ytsurui/RP2040CommandStation/README.md

# RP2040-Based DCC Command Station

underconstruction
