ytsurui/RP2040CommandStation/Board-LargePower/KiCad6/3dmodel/HSIP7_TOS.step

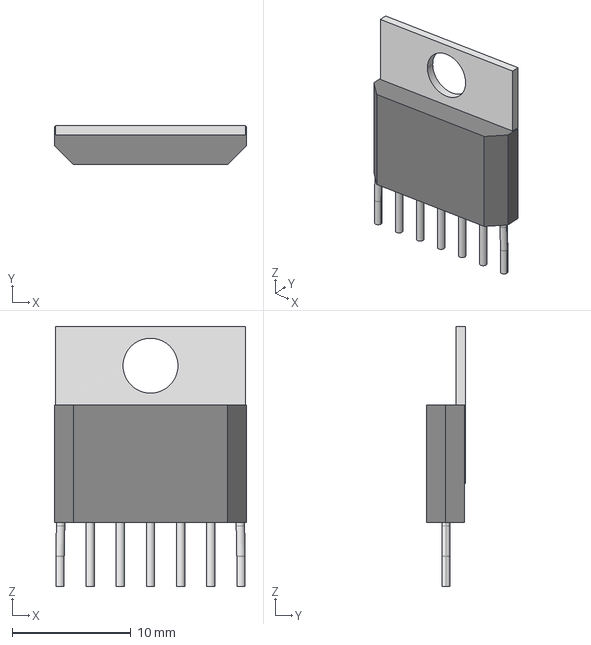
[picture p1: CAD file, 2023-01-30]
Board-LargePower/KiCad6/3dmodel/HSIP7_TOS.step
16.2 x 3.30 x 21.9 mm
