ytsurui/RP2040CommandStation/Board-LargePower/KiCad6/3dmodel/CUI_PJ-002A.igs

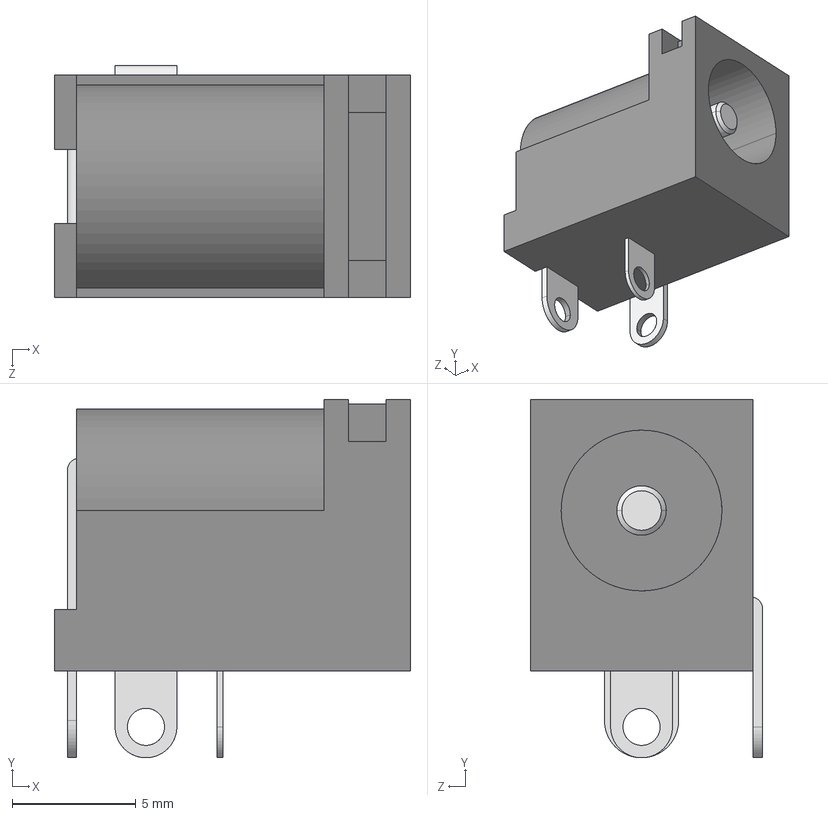
[picture p2: CAD file, 2023-01-30]
Board-LargePower/KiCad6/3dmodel/CUI_PJ-002A.igs
14.4 x 14.5 x 9.40 mm
