ytsurui/RP2040CommandStation/Board-LargePower/KiCad6/3dmodel/KUSBEX-BSFS1N-W_A.STEP

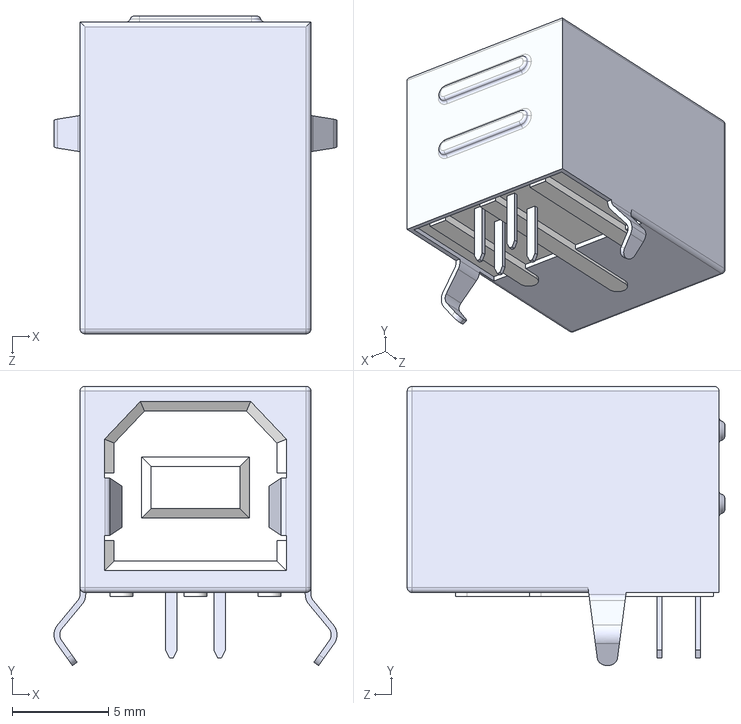
[picture p3: CAD file, 2023-01-30]
Board-LargePower/KiCad6/3dmodel/KUSBEX-BSFS1N-W_A.STEP
14.7 x 14.5 x 16.5 mm
