ytsurui/RP2040CommandStation/Board-UltraPower/KiCad6/RP2040CommandStation.kicad_pcb

## KiCad design Board-UltraPower/KiCad6/RP2040CommandStation.kicad_pcb (2023-06-03)

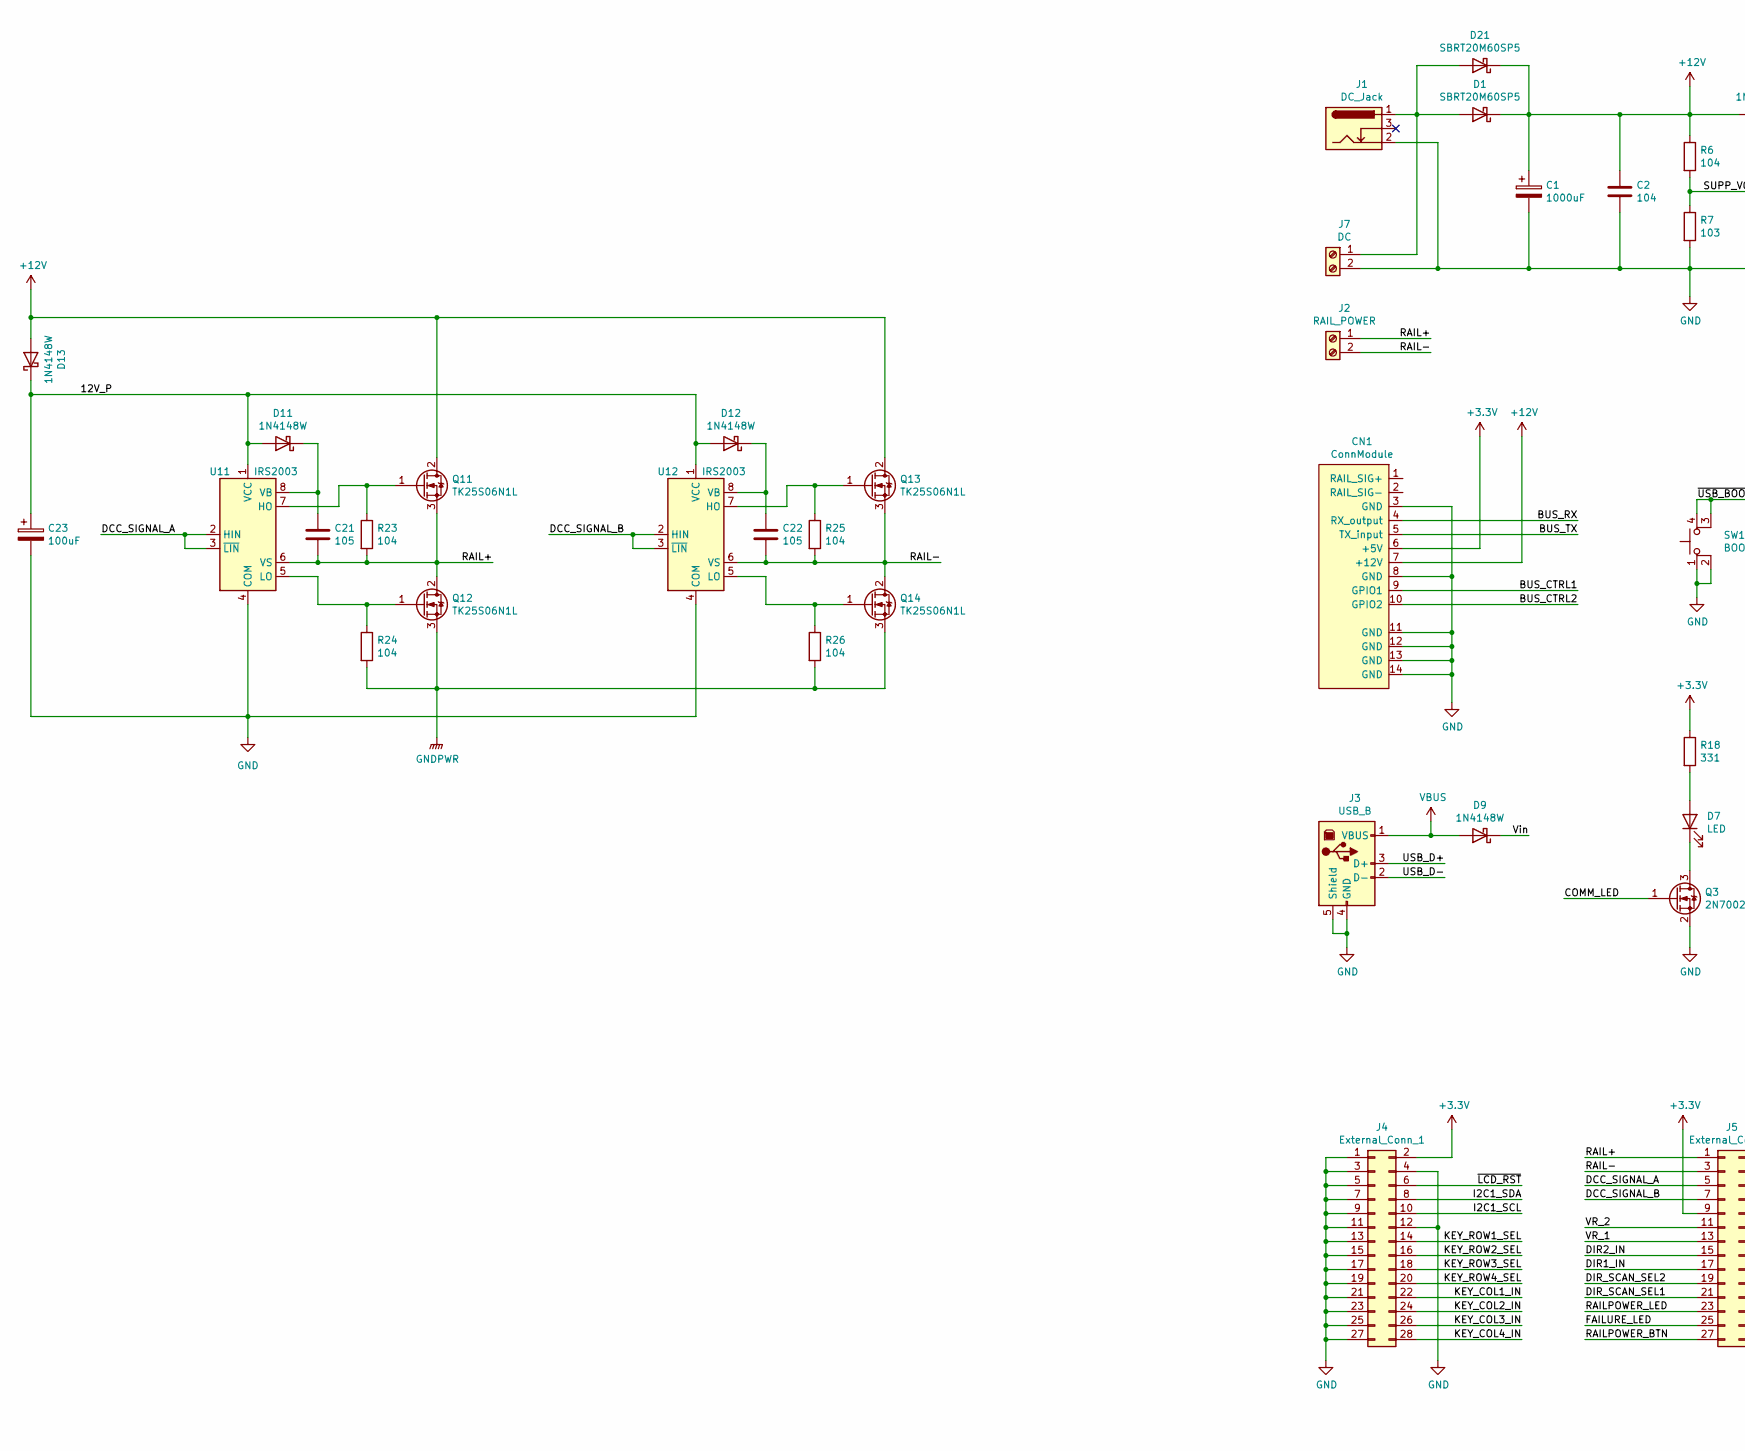
[picture p4: schematic RP2040CommandStation.kicad_sch, part in row 1, column 1]

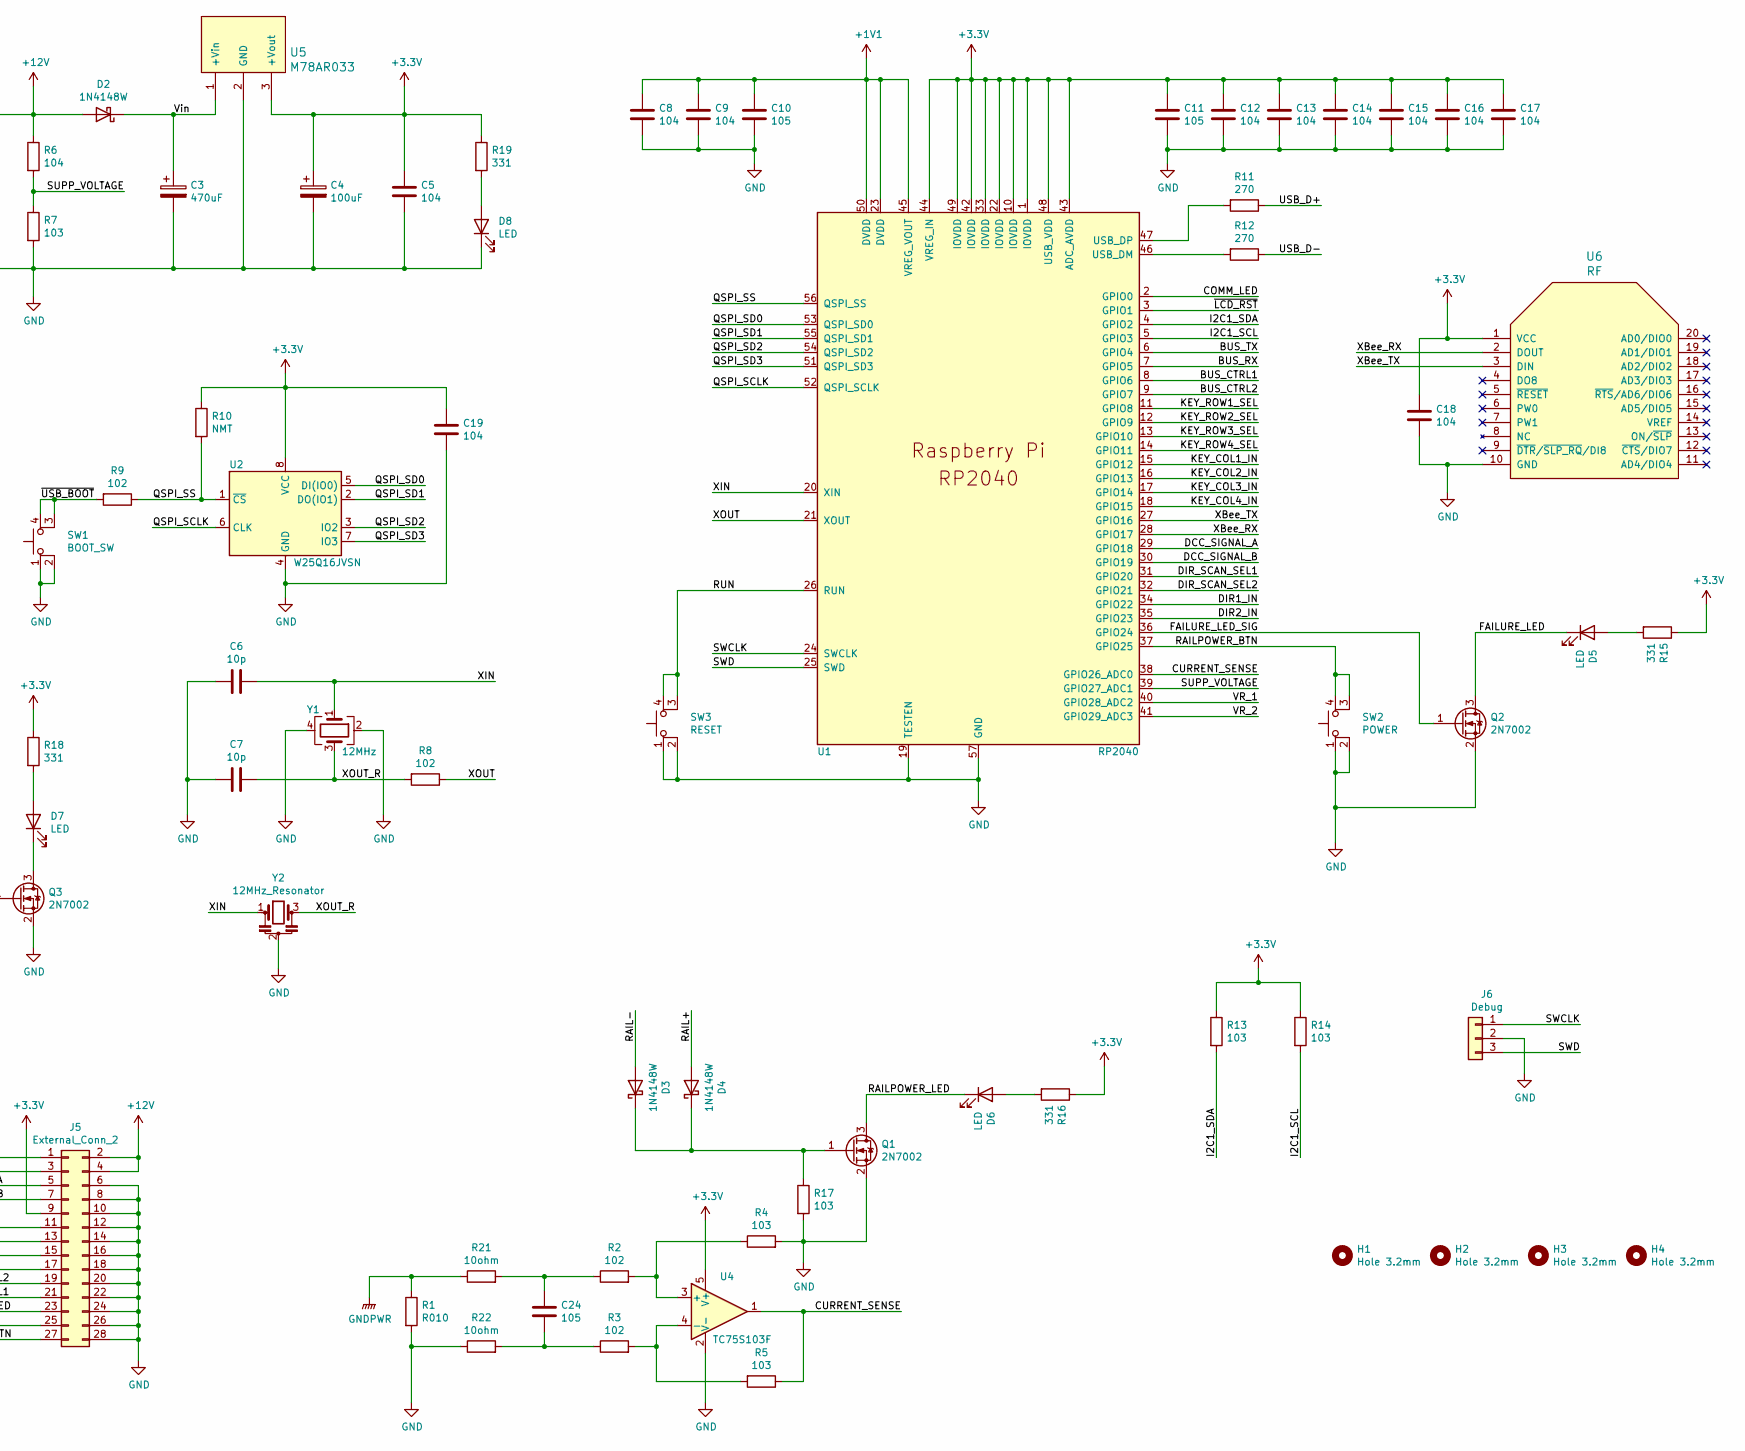
[picture p5: schematic RP2040CommandStation.kicad_sch, part in row 1, column 2]

Parts:
C1: 1000uF; CAP_TH_12_5
C2, C5, C8, C9, C12, C13, C14, C15, C16, C17, C18, C19: 104; C_1005
C3: 470uF; CAP_TH_8x11_5
C4, C23: 100uF; CAP_TH_5x11
C6, C7: 10p; C_1005
C10, C11, C21, C22, C24: 105; C_1005
CN1: ConnModule; CommModuleTiny
D1, D21: SBRT20M60SP5; POWERDI5
D2, D3, D4, D9, D11, D12, D13: 1N4148W; SOD-123FL
D5, D6, D7, D8: LED; LED_3mm
H1, H2, H3, H4: Hole 3.2mm; HOLE_3.2mm
J1: DC_Jack; BARREL_JACK
J2: RAIL_POWER; TB111-2
J3: USB_B
J4: External_Conn_1; PinSocket_2x14_2_54mm
J5: External_Conn_2; PinSocket_2x14_2_54mm
J6: Debug; PinHeader_01x03
J7: DC; TB111-2
Q1, Q2, Q3: 2N7002; SOT-23
Q11, Q12, Q13, Q14: TK25S06N1L; DPAK+
R1: R010; R_6432
R2, R3, R8, R9: 102; R_1608
R4, R5, R7, R13, R14, R17: 103; R_1608
R6, R23, R24, R25, R26: 104; R_1608
R10: NMT; R_1608
R11, R12: 270; R_1608
R15, R16, R18, R19: 331; R_1608
R21, R22: 10ohm; R_1608
SW1: BOOT_SW; TS-0606
SW2: POWER; TS-0606
SW3: RESET; TS-0606
U1: RP2040; RP2040-QFN-56
U2: W25Q16JVSN; SO-8
U4: TC75S103F; SOT-23-5
U5: M78AR033; M78AR0XX
U6: RF; XBee
U11, U12: IRS2003; SO-8
Y1: 12MHz; FA-238_Crystal
Y2: 12MHz_Resonator; SMD_Resonator_3213

Connections:
+1V1: C8.1, C9.1, C10.1, U1.23 (DVDD), U1.45 (VREG_VOUT), U1.50 (DVDD)
+3.3V: C4.1, C5.1, C11.1, C12.1, C13.1, C14.1, C15.1, C16.1, C17.1, C18.1, C19.1, CN1.6 (+5V), J4.2, J5.9, R10.1, R13.1, R14.1, R15.1, R16.1, R18.1, R19.1, U1.1 (IOVDD), U1.10 (IOVDD), U1.22 (IOVDD), U1.33 (IOVDD), U1.42 (IOVDD), U1.43 (ADC_AVDD), U1.44 (VREG_IN), U1.48 (USB_VDD), U1.49 (IOVDD), U2.8 (VCC), U4.5 (V+), U5.3 (+Vout), U6.1 (VCC)
+12V: C1.1, C2.1, CN1.7 (+12V), D1.1 (K), D2.2 (A), D13.2 (A), D21.1 (K), J5.2, J5.4, Q11.2 (D), Q13.2 (D), R6.1
/12V_P: C23.1, D11.2 (A), D12.2 (A), D13.1 (K), U11.1 (VCC), U12.1 (VCC)
/BUS_CTRL1: CN1.9 (GPIO1), U1.8 (GPIO6)
/BUS_CTRL2: CN1.10 (GPIO2), U1.9 (GPIO7)
/BUS_RX: CN1.4 (RX_output), U1.7 (GPIO5)
/BUS_TX: CN1.5 (TX_input), U1.6 (GPIO4)
/COMM_LED: Q3.1 (G), U1.2 (GPIO0)
/CURRENT_SENSE: R5.1, U1.38 (GPIO26_ADC0), U4.1
/DCC_SIGNAL_A: J5.5, U1.29 (GPIO18), U11.2 (HIN), U11.3 (~LIN)
/DCC_SIGNAL_B: J5.7, U1.30 (GPIO19), U12.2 (HIN), U12.3 (~LIN)
/DIR1_IN: J5.17, U1.34 (GPIO22)
/DIR2_IN: J5.15, U1.35 (GPIO23)
/DIR_SCAN_SEL1: J5.21, U1.31 (GPIO20)
/DIR_SCAN_SEL2: J5.19, U1.32 (GPIO21)
/FAILURE_LED: D5.1 (K), J5.25, Q2.3 (D)
/FAILURE_LED_SIG: Q2.1 (G), U1.36 (GPIO24)
/I2C1_SCL: J4.10, R14.2, U1.5 (GPIO3)
/I2C1_SDA: J4.8, R13.2, U1.4 (GPIO2)
/KEY_COL1_IN: J4.22, U1.15 (GPIO12)
/KEY_COL2_IN: J4.24, U1.16 (GPIO13)
/KEY_COL3_IN: J4.26, U1.17 (GPIO14)
/KEY_COL4_IN: J4.28, U1.18 (GPIO15)
/KEY_ROW1_SEL: J4.14, U1.11 (GPIO8)
/KEY_ROW2_SEL: J4.16, U1.12 (GPIO9)
/KEY_ROW3_SEL: J4.18, U1.13 (GPIO10)
/KEY_ROW4_SEL: J4.20, U1.14 (GPIO11)
/QSPI_SCLK: U1.52 (QSPI_SCLK), U2.6 (CLK)
/QSPI_SD0: U1.53 (QSPI_SD0), U2.5 (DI(IO0))
/QSPI_SD1: U1.55 (QSPI_SD1), U2.2 (DO(IO1))
/QSPI_SD2: U1.54 (QSPI_SD2), U2.3 (IO2)
/QSPI_SD3: U1.51 (QSPI_SD3), U2.7 (IO3)
/QSPI_SS: R9.1, R10.2, U1.56 (QSPI_SS), U2.1 (~CS)
/RAIL+: C21.2, D4.2 (A), J2.1, J5.1, Q11.3 (S), Q12.2 (D), R23.2, U11.6 (VS)
/RAIL-: C22.2, D3.2 (A), J2.2, J5.3, Q13.3 (S), Q14.2 (D), R25.2, U12.6 (VS)
/RAILPOWER_BTN: J5.27, SW2.3 (K), SW2.4 (A), U1.37 (GPIO25)
/RAILPOWER_LED: D6.1 (K), J5.23, Q1.3 (D)
/RUN: SW3.3 (K), SW3.4 (A), U1.26 (RUN)
/SUPP_VOLTAGE: R6.2, R7.1, U1.39 (GPIO27_ADC1)
/SWCLK: J6.1, U1.24 (SWCLK)
/SWD: J6.3, U1.25 (SWD)
/USB_D+: J3.3 (D+), R11.1
/USB_D-: J3.2 (D-), R12.1
/VR_1: J5.13, U1.40 (GPIO28_ADC2)
/VR_2: J5.11, U1.41 (GPIO29_ADC3)
/Vin: C3.1, D2.1 (K), D9.1 (K), U5.1 (+Vin)
/XBee_RX: U1.28 (GPIO17), U6.2 (DOUT)
/XBee_TX: U1.27 (GPIO16), U6.3 (DIN)
/XIN: C6.1, U1.20 (XIN), Y1.1, Y2.1
/XOUT: R8.1, U1.21 (XOUT)
/XOUT_R: C7.1, R8.2, Y1.3, Y2.3
/~LCD_RST: J4.6, U1.3 (GPIO1)
/~USB_BOOT: R9.2, SW1.3 (K), SW1.4 (A)
GNDPWR: Q12.3 (S), Q14.3 (S), R1.1, R21.1, R24.2, R26.2
unnamed: C21.1, D11.1 (K), U11.8 (VB)
unnamed: C22.1, D12.1 (K), U12.8 (VB)
unnamed: C24.1, R2.1, R21.2
unnamed: C24.2, R3.1, R22.2
unnamed: D1.2 (A), D21.2 (A), J1.1, J7.1
unnamed: D3.1 (K), D4.1 (K), Q1.1 (G), R17.1
unnamed: D5.2 (A), R15.2
unnamed: D6.2 (A), R16.2
unnamed: D7.1 (K), Q3.3 (D)
unnamed: D7.2 (A), R18.2
unnamed: D8.2 (A), R19.2
unnamed: Q11.1 (G), R23.1, U11.7 (HO)
unnamed: Q13.1 (G), R25.1, U12.7 (HO)
unnamed: Q14.1 (G), R26.1, U12.5 (LO)
unnamed: R2.2, R4.1, U4.3 (+)
unnamed: R3.2, R5.2, U4.4 (-)
unnamed: R11.2, U1.47 (USB_DP)
unnamed: R12.2, U1.46 (USB_DM)
unnamed: Q12.1 (G), R24.1, U11.5 (LO)
VBUS: D9.2 (A), J3.1 (VBUS)

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
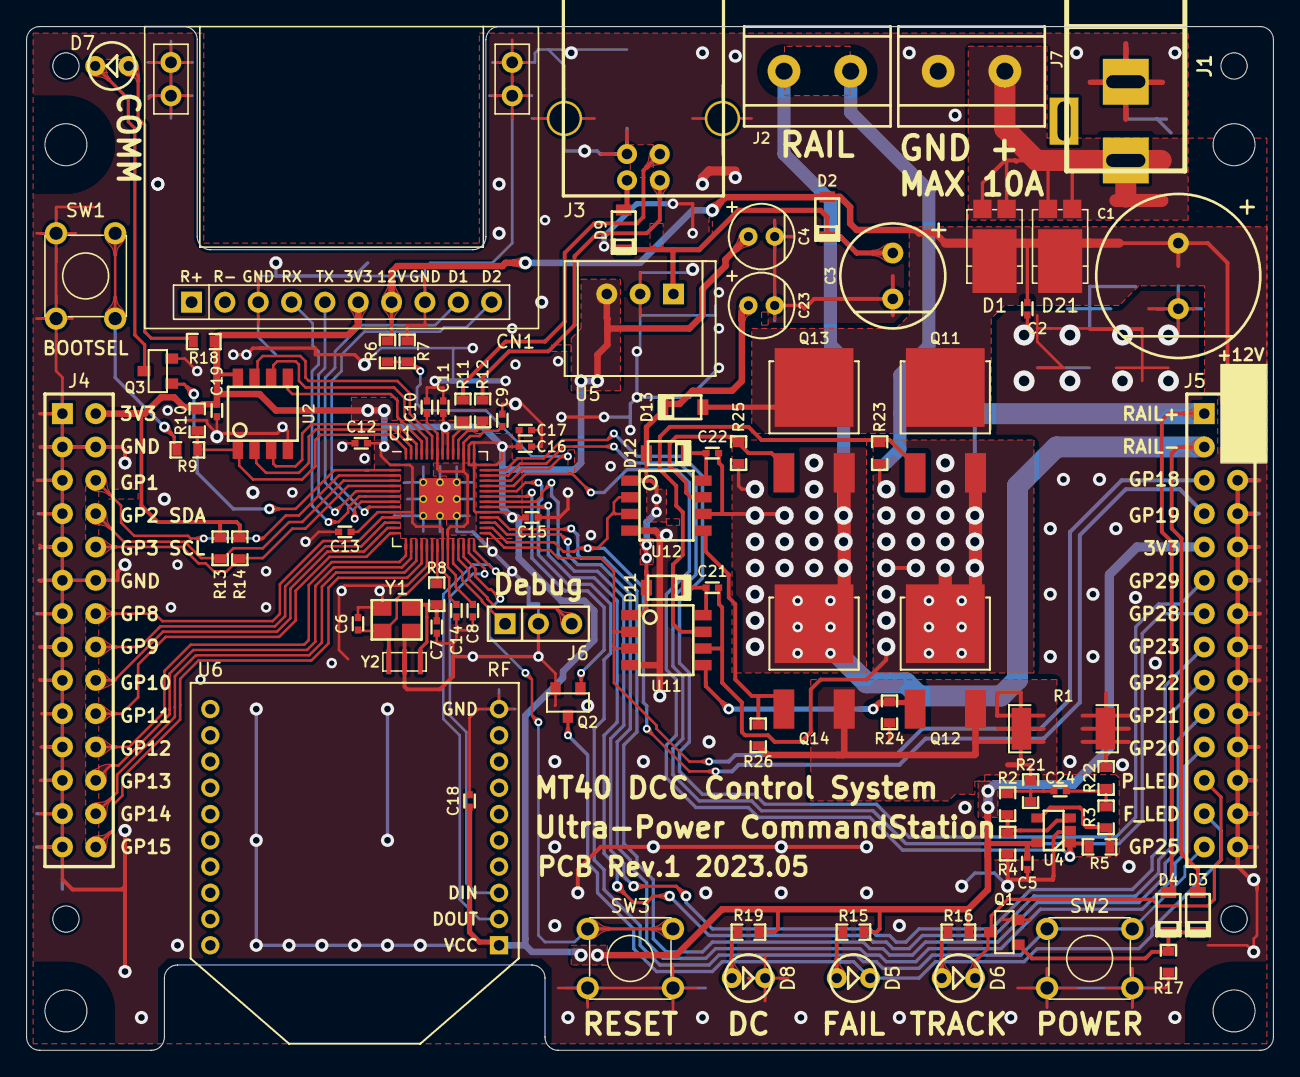
[picture p6: board RP2040CommandStation.kicad_pcb from above]

Board: 2 copper layers, 95.0 x 78.0 mm, 92 parts (0 on the bottom side), 76 nets.
