ytsurui/RP2040CommandStation/Keypad/KiCad/RP2040CommandStationKeypad.kicad_pcb

## KiCad design Keypad/KiCad/RP2040CommandStationKeypad.kicad_pcb (2023-01-30)

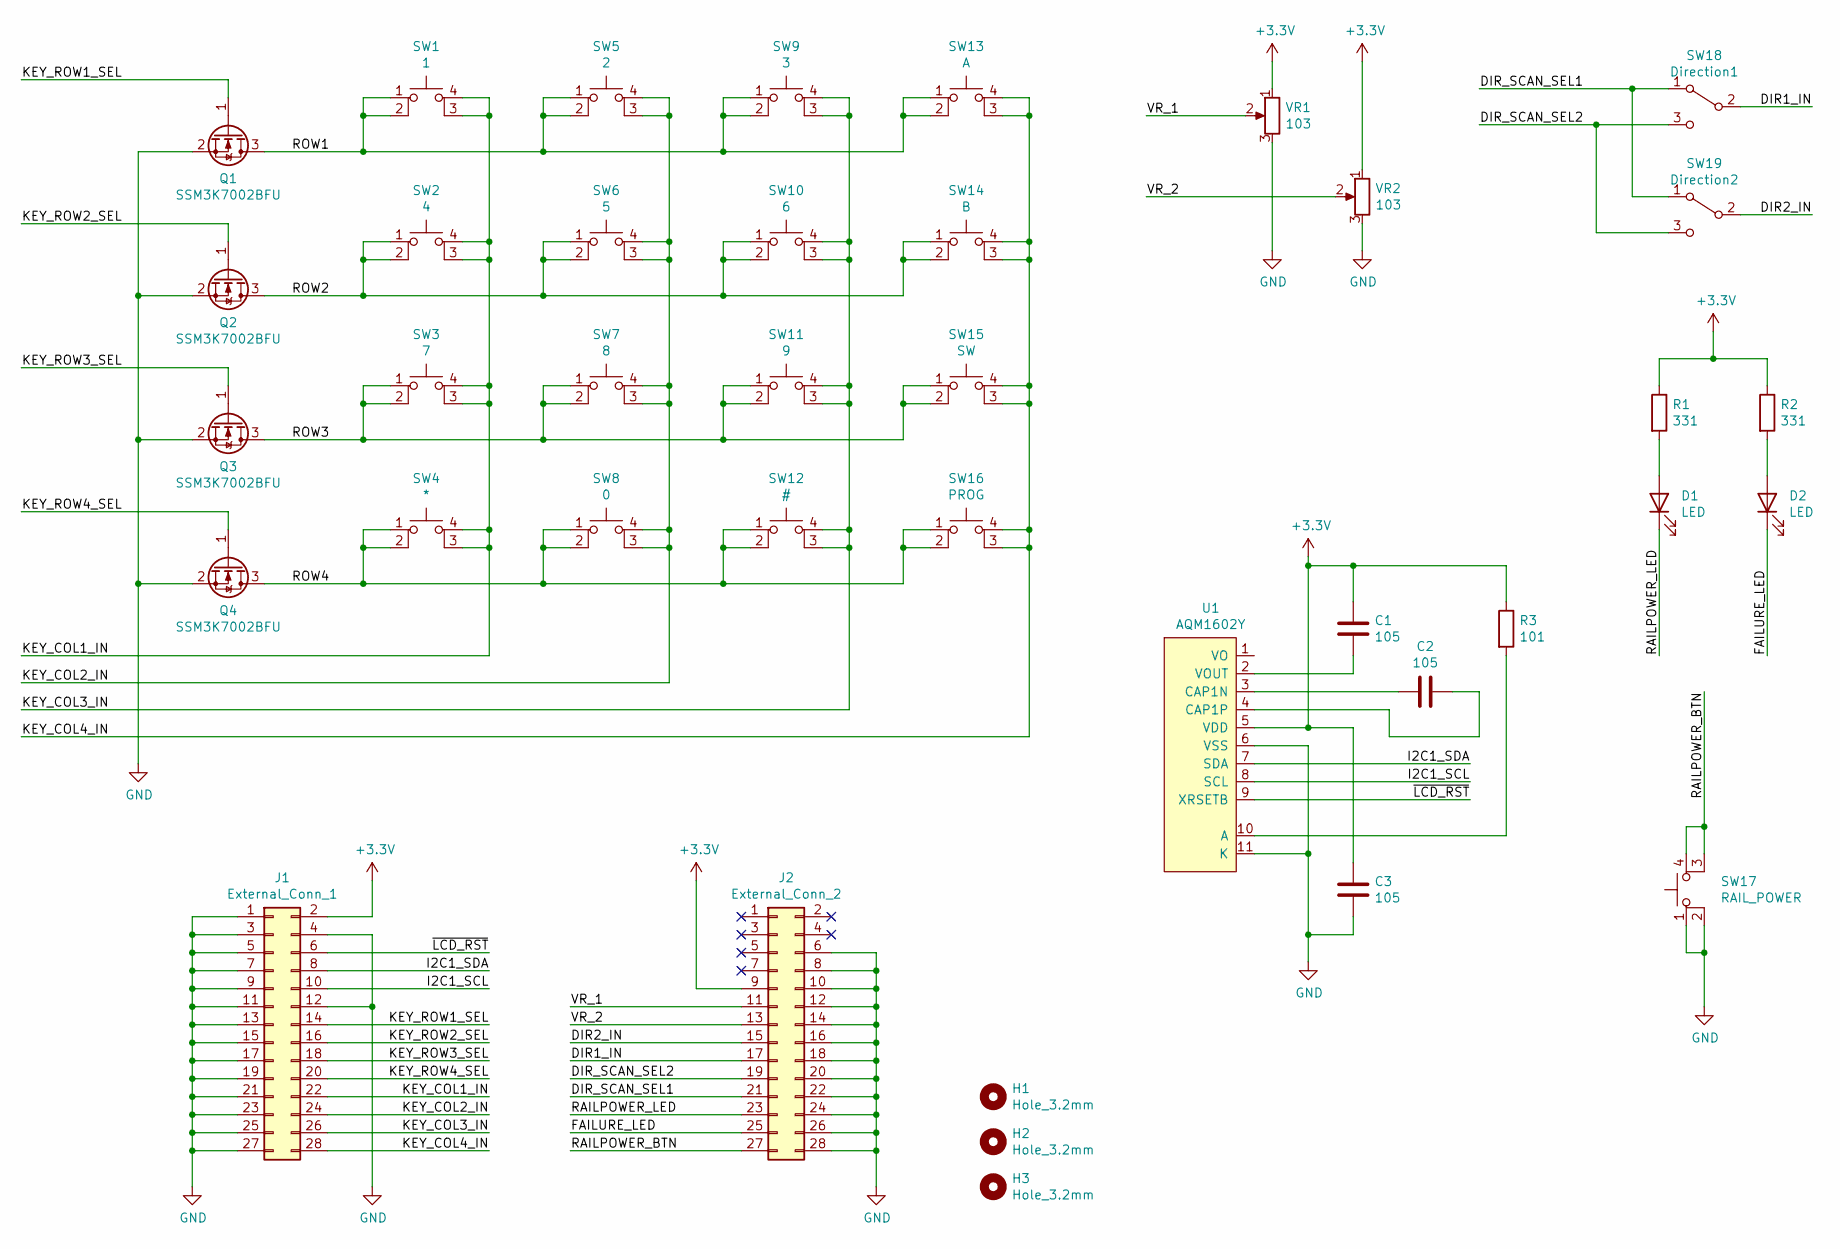
[picture p7: schematic RP2040CommandStationKeypad.sch]

Parts:
C1, C2, C3: 105; C_1005
D1, D2: LED; LED_3mm
H1, H2, H3: Hole_3.2mm; HOLE_3.2mm
J1: External_Conn_1; PinHeader_Reverse_2x14_2_54mm
J2: External_Conn_2; PinHeader_Reverse_2x14_2_54mm
Q1, Q2, Q3, Q4: SSM3K7002BFU; SC-70
R1, R2: 331; R_1608
R3: 101; R_1608
SW1: 1; TS-0606
SW2: 4; TS-0606
SW3: 7; TS-0606
SW4: *; TS-0606
SW5: 2; TS-0606
SW6: 5; TS-0606
SW7: 8; TS-0606
SW8: 0; TS-0606
SW9: 3; TS-0606
SW10: 6; TS-0606
SW11: 9; TS-0606
SW12: #; TS-0606
SW13: A; TS-0606
SW14: B; TS-0606
SW15: SW; TS-0606
SW16: PROG; TS-0606
SW17: RAIL_POWER; TS-0606
SW18: Direction1; TOGGLE_SW_1C
SW19: Direction2; TOGGLE_SW_1C
U1: AQM1602Y
VR1, VR2: 103; ALPS-SLIDEVOLUME

Connections:
+3V3: C1.1, C3.1, J1.2, J2.9, R1.1, R2.1, R3.1, U1.5 (VDD), VR1.1, VR2.1
/DIR1_IN: J2.17, SW18.2 (B)
/DIR2_IN: J2.15, SW19.2 (B)
/DIR_SCAN_SEL1: J2.21, SW18.1 (A), SW19.1 (A)
/DIR_SCAN_SEL2: J2.19, SW18.3 (C), SW19.3 (C)
/FAILURE_LED: D2.1 (K), J2.25
/I2C1_SCL: J1.10, U1.8 (SCL)
/I2C1_SDA: J1.8, U1.7 (SDA)
/KEY_COL1_IN: J1.22, SW1.3 (K), SW1.4 (A), SW2.3 (K), SW2.4 (A), SW3.3 (K), SW3.4 (A), SW4.3 (K), SW4.4 (A)
/KEY_COL2_IN: J1.24, SW5.3 (K), SW5.4 (A), SW6.3 (K), SW6.4 (A), SW7.3 (K), SW7.4 (A), SW8.3 (K), SW8.4 (A)
/KEY_COL3_IN: J1.26, SW9.3 (K), SW9.4 (A), SW10.3 (K), SW10.4 (A), SW11.3 (K), SW11.4 (A), SW12.3 (K), SW12.4 (A)
/KEY_COL4_IN: J1.28, SW13.3 (K), SW13.4 (A), SW14.3 (K), SW14.4 (A), SW15.3 (K), SW15.4 (A), SW16.3 (K), SW16.4 (A)
/KEY_ROW1_SEL: J1.14, Q1.1 (G)
/KEY_ROW2_SEL: J1.16, Q2.1 (G)
/KEY_ROW3_SEL: J1.18, Q3.1 (G)
/KEY_ROW4_SEL: J1.20, Q4.1 (G)
/RAILPOWER_BTN: J2.27, SW17.3 (K), SW17.4 (A)
/RAILPOWER_LED: D1.1 (K), J2.23
/ROW1: Q1.3 (D), SW1.1, SW1.2, SW5.1, SW5.2, SW9.1, SW9.2, SW13.1, SW13.2
/ROW2: Q2.3 (D), SW2.1, SW2.2, SW6.1, SW6.2, SW10.1, SW10.2, SW14.1, SW14.2
/ROW3: Q3.3 (D), SW3.1, SW3.2, SW7.1, SW7.2, SW11.1, SW11.2, SW15.1, SW15.2
/ROW4: Q4.3 (D), SW4.1, SW4.2, SW8.1, SW8.2, SW12.1, SW12.2, SW16.1, SW16.2
/VR_1: J2.11, VR1.2
/VR_2: J2.13, VR2.2
/~LCD_RST: J1.6, U1.9 (XRSETB)
GND: C3.2, J1.1, J1.3, J1.4, J1.5, J1.7, J1.9, J1.11, J1.12, J1.13, J1.15, J1.17, J1.19, J1.21, J1.23, J1.25, J1.27, J2.6, J2.8, J2.10, J2.12, J2.14, J2.16, J2.18, J2.20, J2.22, J2.24, J2.26, J2.28, Q1.2 (S), Q2.2 (S), Q3.2 (S), Q4.2 (S), SW17.1, SW17.2, U1.6 (VSS), U1.11 (K), VR1.3, VR2.3
unnamed: C1.2, U1.2 (VOUT)
unnamed: C2.1, U1.4 (CAP1P)
unnamed: C2.2, U1.3 (CAP1N)
unnamed: D1.2 (A), R1.2
unnamed: D2.2 (A), R2.2
unnamed: R3.2, U1.10 (A)

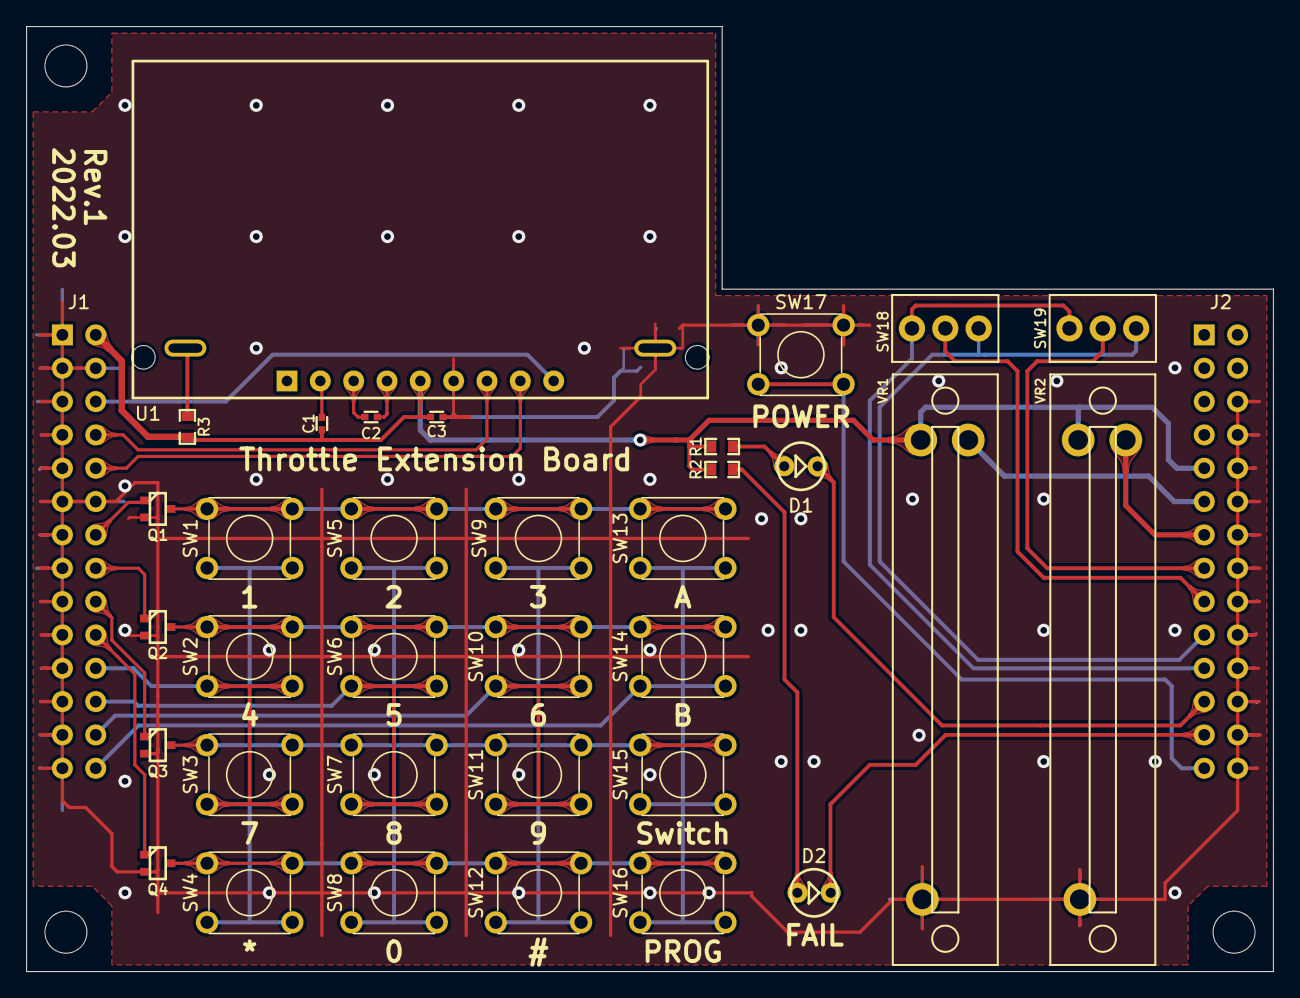
[picture p8: board RP2040CommandStationKeypad.kicad_pcb from above]

Board: 2 copper layers, 95.0 x 72.0 mm, 39 parts (0 on the bottom side), 32 nets.
