ytsurui/RP2040CommandStation/Firmware/peripheral/powerButton.h

class powerbutton
{
public:
    static void init(void);
    static void event(void);
    static bool checkChange(void);
    static bool readStat(void);

private:
    static uint8_t counter;
    static uint8_t flag;
};
/*
void initPowerButton(void);
void eventPowerButton(void);
bool checkChangePowerButtonStat(void);
bool readPowerButtonStat(void);
*/
