ytsurui/RP2040CommandStation/(commit log)

2023-05-19 ボタン類の動作を調整
2023-05-19 Loconetの車両アドレス解放後の動作を修正
2023-05-19 大出力版の設定を追加
2023-05-19 デバッグ用メッセージを追加
2023-05-23 列車オブジェクトを取得時に見つからない場合は自動生成する機能を追加
2023-05-23 Loconetのタイムアウト間隔を調整
2023-05-23 独自通信バスの関数群荒削り版の追加
2023-05-23 ビルド時に独自バスのソースコードを読み込むように変更
2023-05-23 環境変数のPICO_SDK_PATHを強制的に読み込むように変更
2023-05-24 線路電源状態の取得用関数を追加
2023-05-24 初期動作テスト用の調整・デバッグ用機能の追加
2023-05-24 通信バスプロトコルを独自のものに変更
2023-05-24 データ送出用関数を追加
2023-05-24 コマンド文字列中のスペースを無視するように変更
2023-05-24 独自バス: ステータス取得(電源/アクセサリ)を追加
2023-05-25 列車速度の読み出し機能を追加
2023-05-25 データ読み出しパケットの処理系を追加
2023-05-25 スペース処理のバグを修正
2023-05-27 通信バス用GPIOの処理を追加
2023-05-27 Carrier-Senseの処理を仮追加
2023-05-29 ECHO / CPS / LBUSコマンドの処理を追加
2023-05-30 電流設定方法をCMakeLists.txtに移動 / CPSコマンドに最大電流が出力されるように変更
2023-05-30 複数チャネルからのデータ受信に対応するように変更
2023-05-30 USBコマンド受信機能の追加 / コマンド終了文字の変更 / ゼロデータ命令の取り扱い不具合を修正
    [datareceiver.cpp, main.cpp, mt40bus.h]
2023-05-30 デバッグメッセージの出力を抑制
2023-05-30 電流値の設定方法を変更
2023-06-03 アクセサリ出力の極性反転を修正
2023-06-03 LBUSの送信処理を全て処理するコールバック機能を追加
2023-06-03 MT40BUSにオフロードされたLBUSプロトコルの処理機能を追加
2023-06-03 defineでLBUSの処理を切り替えられるように変更
2023-06-03 UltraPower版の基板設計データを追加
    [RP2040CommandStation.GBL, RP2040CommandStation.GBO, RP2040CommandStation.GBP, RP2040CommandStation.GBS, RP2040CommandStation.GTL, RP2040CommandStation.GTO, RP2040CommandStation.GTP, RP2040CommandStation.GTS]
2023-06-09 ローカルパケットの識別に対応
2023-06-09 認識可能な10進数の桁数を増加
2023-06-10 4文字コマンドが処理できない問題を修正
2023-06-14 L-BUSのパケット処理不具合を修正
2023-06-14 F29-F68の制御処理・パケット処理を追加
2023-06-14 TOSコマンドで出力されるステータスが反転していた問題を修正
2023-06-30 Loconetの受信処理を修正 / 受信時USBへのルーティングを削除
2023-06-30 不明なパケットの対応を追加
2023-06-30 パケット送信時の遅延を修正
2023-06-30 F29-F68の対応漏れを修正
2023-06-30 起動時のバージョン情報表示機能を追加
2023-07-17 無線側にMT40BUSの応答を返さない不具合を修正
2023-07-17 private packetの処理を追加
2023-08-06 Root/Robotモードの実装準備
2023-09-19 Root/Robotモード時の制御で、 lastCtrlCounterをリセットするように変更
2023-09-19 電源ボタンの挙動を改善
2023-09-19 キーパッドのチャタリング改善
2023-12-14 プログラム線路の挙動を修正
2023-12-17 PowerManagerの制御コマンドを追加
2023-12-17 L-BUSの電源オンオフコマンドをPowerManagerに連携
2024-01-12 PW / PWTコマンド実行後にPWSコマンドによる状態出力を実施する機能を追加
2024-01-12 Cutout Statusのコマンド実行定義を追加
2024-01-12 本体の電源ボタン操作を行った際にPWSコマンドを送出する機構を追加
2024-01-12 未知のコマンドを受信した際にフリーズする問題の修正
2024-01-12 アドレス指定なしのPMUPコマンド送出時に不要コマンドが送信される問題の修正
2024-01-12 本体のPOWERボタンを押した際に、PMUPコマンドを送出する機能を追加
2024-01-15 コマンド解析エンジンの変更テスト
2024-01-17 パケット受信処理を環境依存しない構造に変更
2024-01-17 PMUPパケットの送信に遅延を持たせるように変更
2024-03-13 '0'のパルス間隔を変更 (デコーダ誤動作対策)
2024-03-14 BiDi Cutoutのオンオフ切り替えを追加
2024-03-14 BiDi Commandの追加
2024-03-15 パケットデータ破棄の条件を変更
2024-03-15 データ送信開始時に前コマンドを完了させるように変更
2024-03-15 速度情報が規定値から溢れた時の処理を変更
2024-03-15 バージョン番号を変更
2024-06-22 robotctrl: if文のバグを修正
2024-06-22 Root/Robotモード: RDIT commandのバグを修正
2024-06-22 Root/Robotモード: 操作時に即座に速度・進行方向が反映されるように変更
2024-06-22 電圧モニタ: 緊急停止作動の電源電圧レベルを緩和
2024-08-16 overcurrent shutdownのデバッグメッセージを削除
2025-03-08 Root/Robotモード: 不正値対策と受信時の内部カウンタ処理を追加
2025-03-08 無線モジュールの初期化機能を追加
2025-03-08 データ送信: 32ビットの限界値近くに対応していない問題の修正 / private packetに対応
    [datasender.cpp, mt40bus.h]
2025-03-08 WCFGコマンド (無線モジュール設定取得) に対応
2025-03-08 WCFGコマンド関連のファイルをCMakeListに追加
2025-09-09 F13以降のパケット送出タイミングの計算バグを修正
2025-12-24 列車制御の初期化バグ、14/28スピードステップのバグを修正
2025-12-24 パケットスケジューラの調整
2026-09-20 TO / TOSコマンドの方向を修正
2026-09-20 DIコマンドが即座に反映されない問題を修正
2026-09-21 車両情報スキャン間隔の調整
2026-09-21 車両パケット送信回数の変更
2026-09-21 14/28 stepコマンドの受信処理を修正
2026-09-21 車両パケット再送間隔を修正
2026-09-21 車両操作時の優先送信機構を追加
